FirstRaid/esp8266-mqtt-scale/climate_monitor/secrets.h

#ifndef SECRETS_H
#define SECRETS_H

// WiFi Configuration
#define WIFI_SSID "POMPI-LAB"
#define WIFI_PASS "POMPIPOM" // <--- Bitte Passwort eintragen!

// MQTT Broker Configuration (Windows PC)
#define MQTT_SERVER "192.168.4.1"
#define MQTT_PORT 1883
#define MQTT_TOPIC "factory/climate" // Updated for climate monitor
// #define MQTT_USER "user" // Not needed (allow_anonymous true)
// #define MQTT_PASS "pass"

#endif
